das-labor/nixie-clock/README.md

# Nixie-Clock by das Labor
Our Nixie-Clock is a digital clock, which uses classical Nixie-tubes as hour, minute and second display. As tubes there are six kinds of the type Telefunken ZM 1210 used.

# Nixie-Uhr im Labor
Unsere Nixie-Uhr ist eine Digitaluhr, welche klassische Nixie-Röhren als Stunden, Minuten und Sekundenanzeige benutzt. Als Röhren werden sechs Röhren des Typs Telefunken ZM 1210 genutzt.

Weitere Informationen finden sich im [Wiki](http://das-labor.org/wiki/Nixie-Uhr).
