das-labor/nixie-clock/eagle/nixie-uhr-can.pdf

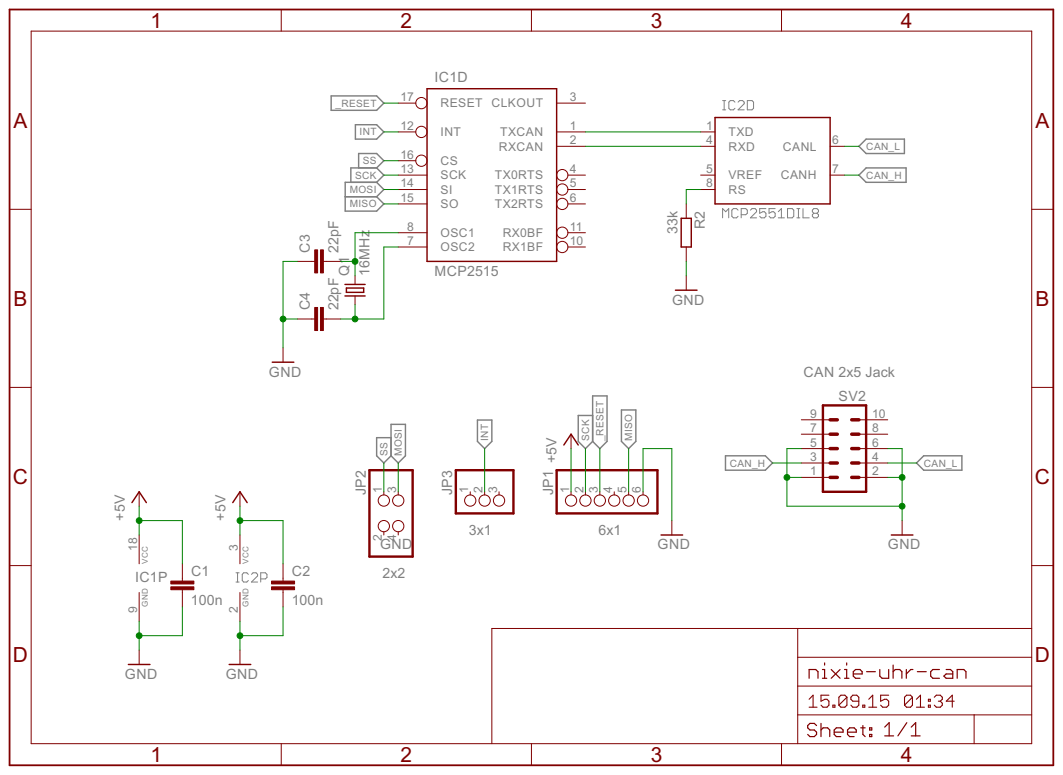
[picture p1: page 1]
