das-labor/nixie-clock/eagle/nixie-uhr.pdf

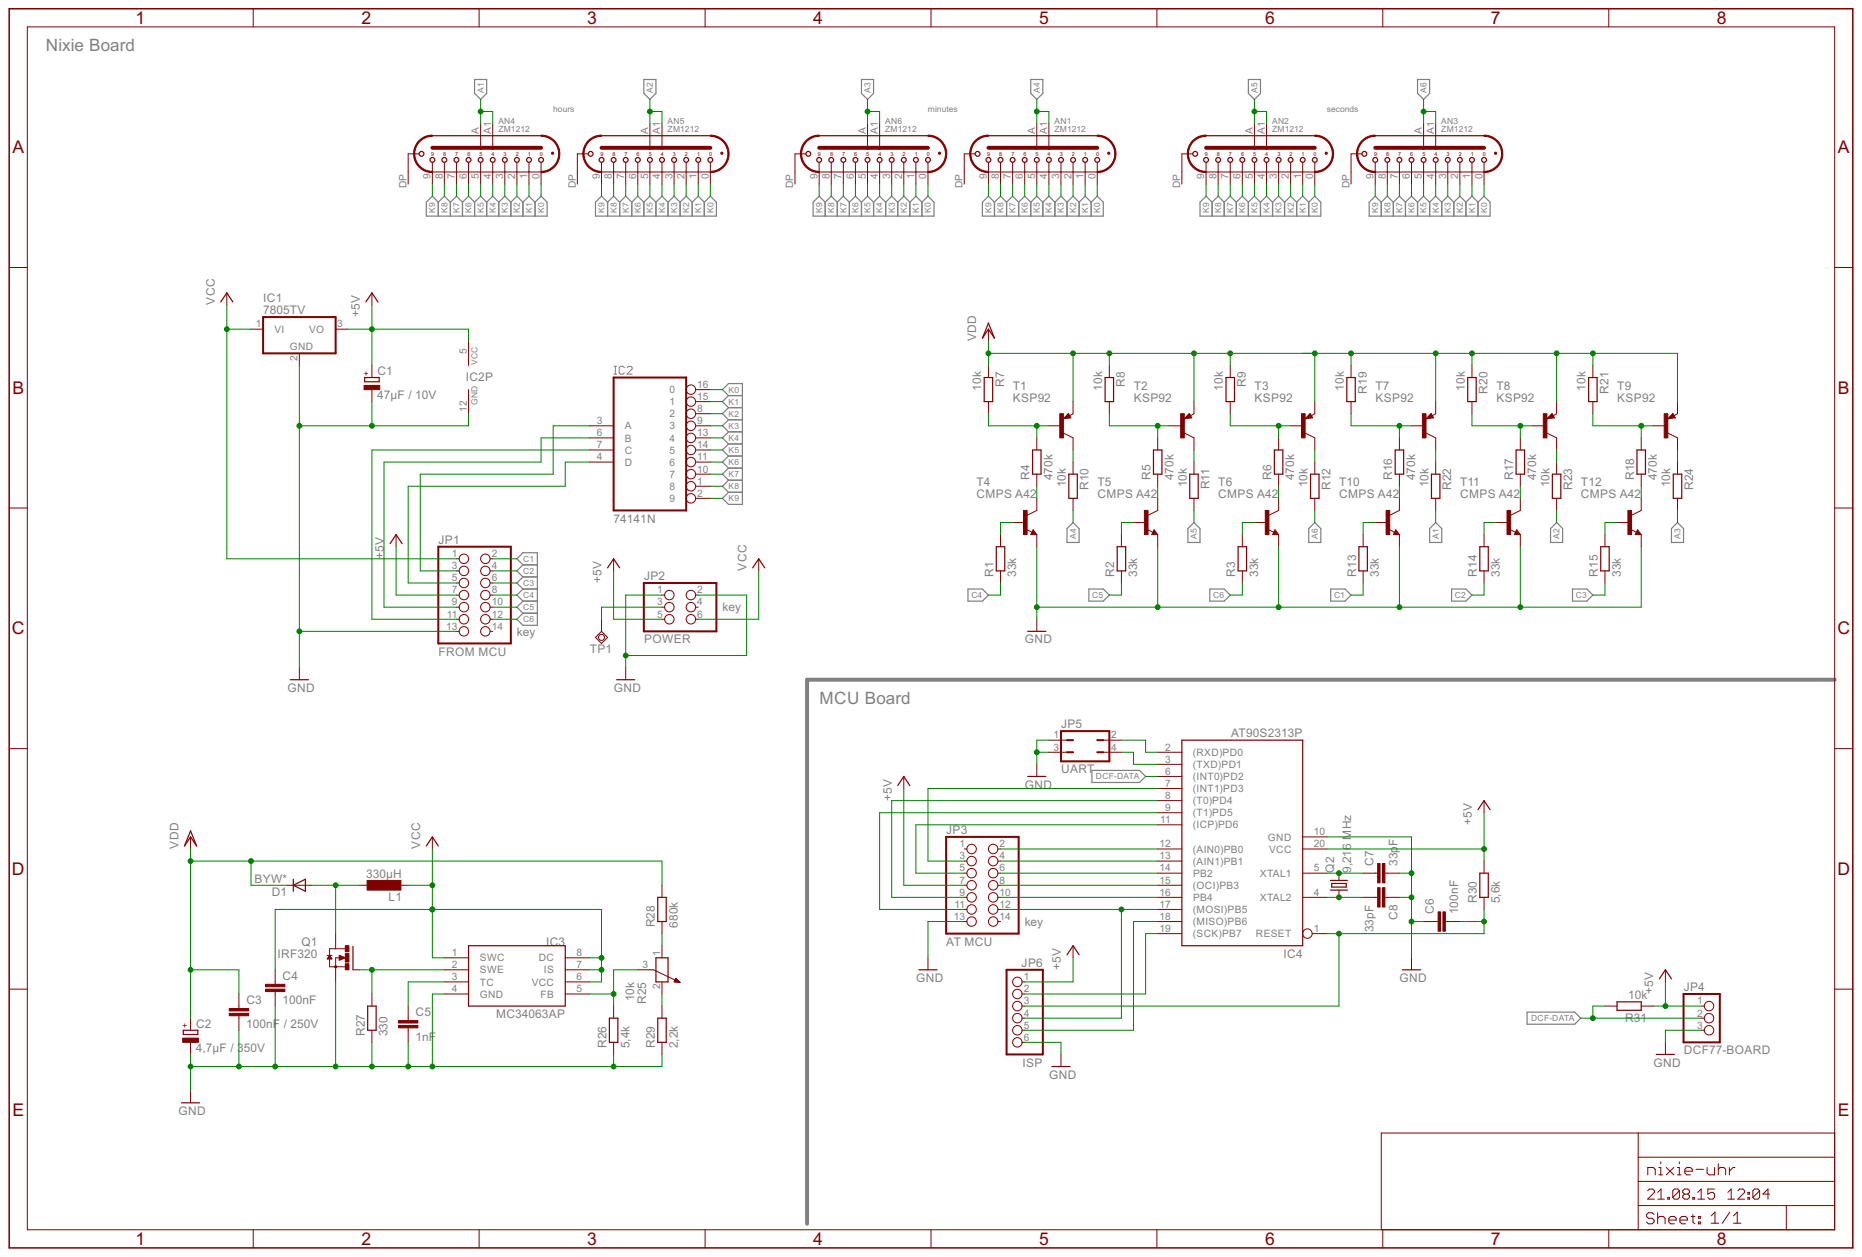
[picture p2: page 1]

11
