das-labor/nixie-clock/eagle/nixie-uhr-can.sch

## EAGLE design eagle/nixie-uhr-can.sch (2015-09-16)

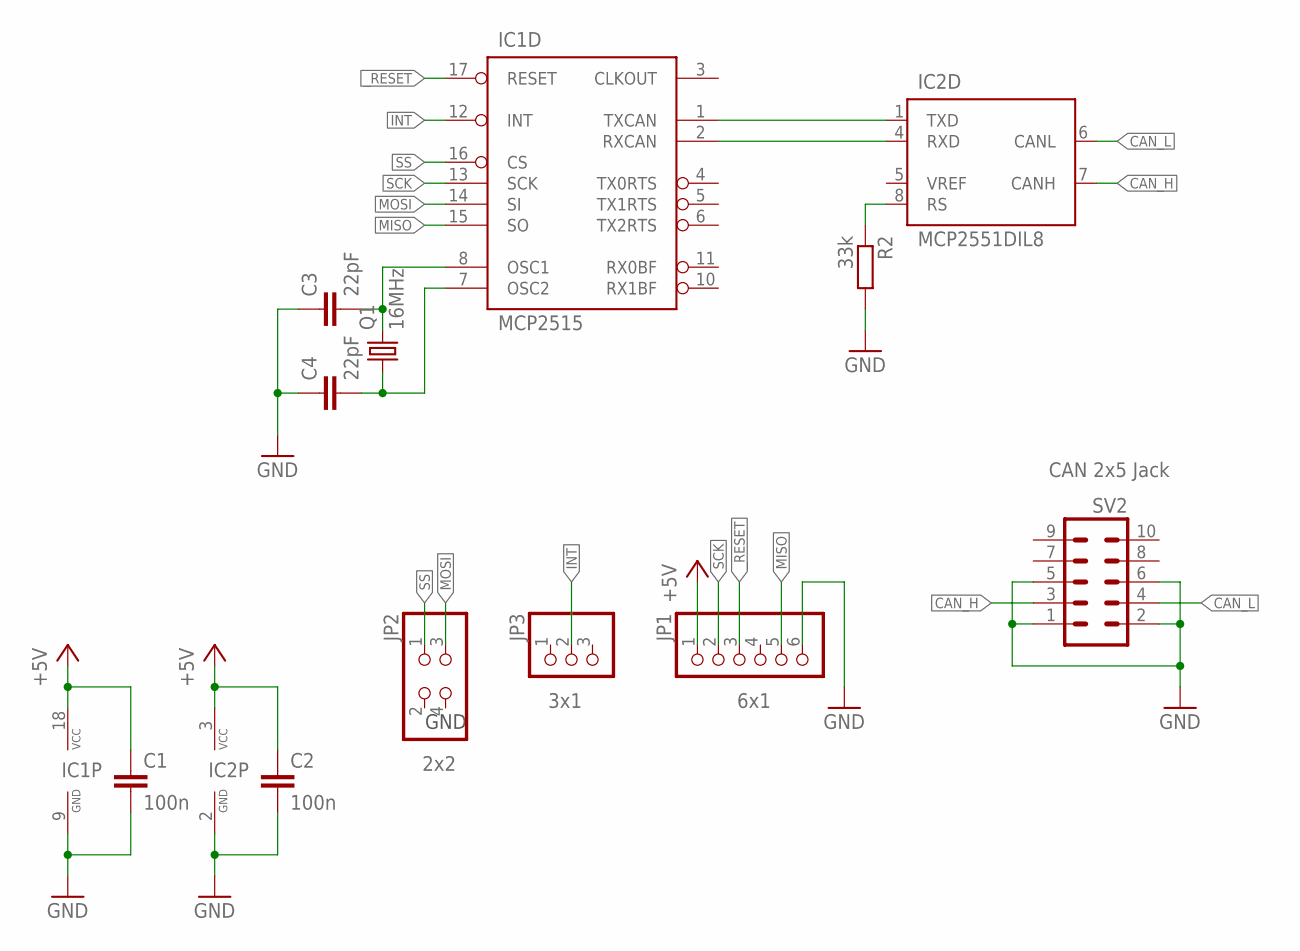
[picture p3: schematic nixie-uhr-can.sch]

Parts:
C1, C2: 100n; C050-024X044
C3, C4: 22pF; C0603
IC1: MCP2515; DIL18
IC2: MCP2551DIL8; DIL08
JP1: 6x1; 1X06/90
JP2: 2x2; 2X02
JP3: 3x1; 1X03
Q1: 16MHz; HC49UP
R2: 33k; 0204/7
SV2: CAN 2x5 Jack; ML10

Connections:
+5V: C1.1, C2.1, IC1.18 (VCC), IC2.3 (VCC), JP1.1
CAN_H: IC2.7 (CANH), SV2.3
CAN_L: IC2.6 (CANL), SV2.4
GND: C1.2, C2.2, C3.1, C4.1, IC1.9 (GND), IC2.2 (GND), JP1.6, R2.2, SV2.1, SV2.2, SV2.5, SV2.6
INT: IC1.12 (INT), JP3.2
MISO: IC1.15 (SO), JP1.5
MOSI: IC1.14 (SI), JP2.3
unnamed: C3.2, IC1.8 (OSC1), Q1.2
unnamed: C4.2, IC1.7 (OSC2), Q1.1
unnamed: IC2.8 (RS), R2.1
unnamed: IC1.1 (TXCAN), IC2.1 (TXD)
unnamed: IC1.2 (RXCAN), IC2.4 (RXD)
SCK: IC1.13 (SCK), JP1.2
SS: IC1.16 (CS), JP2.1
_RESET: IC1.17 (RESET), JP1.3

Notes on the sheet:
GND
