das-labor/nixie-clock/eagle/nixie-uhr.sch

## EAGLE design eagle/nixie-uhr.sch (2015-09-16)

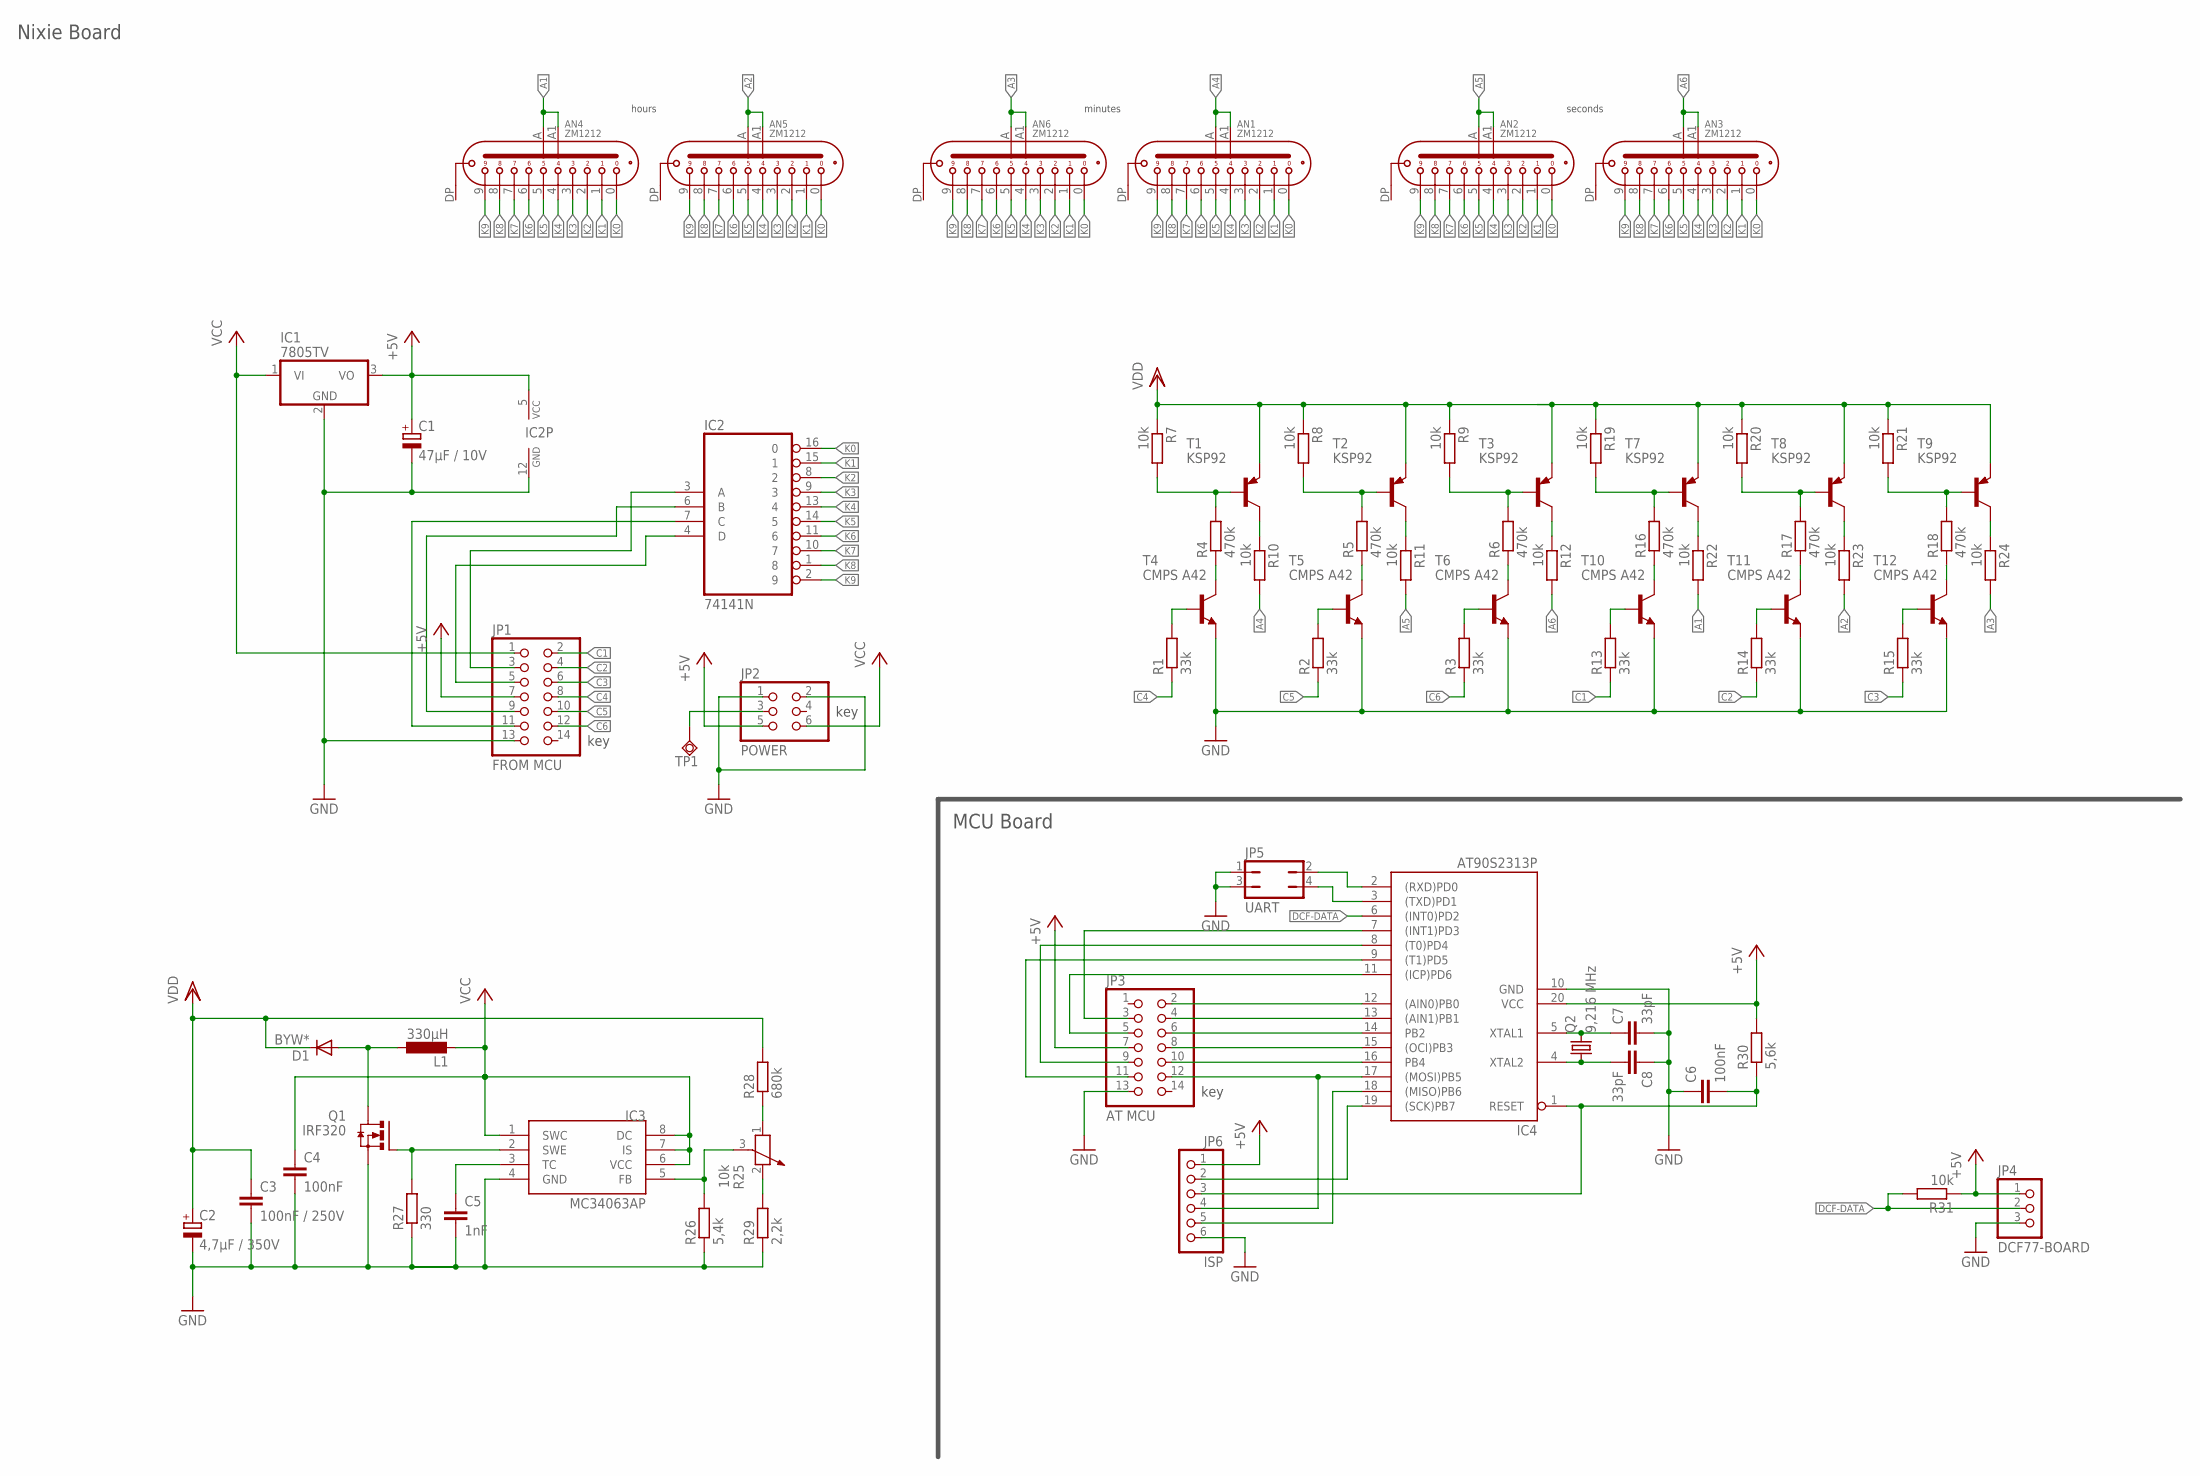
[picture p4: schematic nixie-uhr.sch]

Parts:
AN1, AN2, AN3, AN4, AN5, AN6: ZM1212; ZM1000
C1: 47µF / 10V; E2,5-5
C2: 4,7µF / 350V; E30-10
C3: 100nF / 250V; C075-052X106
C4, C6: 100nF; C050-024X044
C5: 1nF; C050-024X044
C7, C8: 33pF; C050-024X044
D1: BYW*; DO204-10
IC1: 7805TV; TO220V
IC2: 74141N; DIL16
IC3: MC34063AP; DIL08
IC4: AT90S2313P; DIL20
JP1: FROM MCU; 2X07
JP2: POWER; 2X03
JP3: AT MCU; 2X07
JP4: DCF77-BOARD; 1X03
JP5: UART; JP2Q
JP6: ISP; 1X06/90
L1: 330µH; 0207/7
Q1: IRF320; D2PACK
Q2: 9,216 MHz; HC49U-H
R1, R2, R3, R13, R14, R15: 33k; 0204/5
R4, R5, R6, R16, R17, R18: 470k; 0204/5
R7, R8, R9, R10, R11, R12, R19, R20, R21, R22, R23, R24, R31: 10k; 0204/5
R25: 10k; PT-SPIN
R26: 5,4k; 0207/7
R27: 330; 0207/7
R28: 680k; 0309/12
R29: 2,2k; 0309/12
R30: 5,6k; 0204/5
T1, T2, T3, T7, T8, T9: KSP92; TO92
T4, T5, T6, T10, T11, T12: CMPS A42; TO92-CBE
TP1: TPSQPAD1-17; P1-17

Connections:
+5V: C1.+, IC1.3 (VO), IC2.5 (VCC), IC4.20 (VCC), JP1.7, JP2.5, JP3.7, JP4.1, JP6.1, R30.2, R31.1
A1: AN4.A (A1), AN4.A1 (A2), R22.2
A2: AN5.A (A1), AN5.A1 (A2), R23.2
A3: AN6.A (A1), AN6.A1 (A2), R24.2
A4: AN1.A (A1), AN1.A1 (A2), R10.2
A5: AN2.A (A1), AN2.A1 (A2), R11.2
A6: AN3.A (A1), AN3.A1 (A2), R12.2
C1: JP1.2, R13.1
C2: JP1.4, R14.1
C3: JP1.6, R15.1
C4: JP1.8, R1.1
C5: JP1.10, R2.1
C6: JP1.12, R3.1
DCF-DATA: IC4.6 ((INT0)PD2), JP4.2, R31.2
GND: C1.-, C2.-, C3.2, C4.2, C5.2, C6.1, C7.2, C8.1, IC1.2 (GND), IC2.12 (GND), IC3.4 (GND), IC4.10 (GND), JP1.13, JP2.1, JP2.2, JP3.13, JP4.3, JP5.1, JP5.3, JP6.6, Q1.3 (S), R26.1, R27.1, R29.1, T4.E, T5.E, T6.E, T10.E, T11.E, T12.E
K0: AN1.0, AN2.0, AN3.0, AN4.0, AN5.0, AN6.0, IC2.16 (0)
K1: AN1.1, AN2.1, AN3.1, AN4.1, AN5.1, AN6.1, IC2.15 (1)
K2: AN1.2, AN2.2, AN3.2, AN4.2, AN5.2, AN6.2, IC2.8 (2)
K3: AN1.3, AN2.3, AN3.3, AN4.3, AN5.3, AN6.3, IC2.9 (3)
K4: AN1.4, AN2.4, AN3.4, AN4.4, AN5.4, AN6.4, IC2.13 (4)
K5: AN1.5, AN2.5, AN3.5, AN4.5, AN5.5, AN6.5, IC2.14 (5)
K6: AN1.6, AN2.6, AN3.6, AN4.6, AN5.6, AN6.6, IC2.11 (6)
K7: AN1.7, AN2.7, AN3.7, AN4.7, AN5.7, AN6.7, IC2.10 (7)
K8: AN1.8, AN2.8, AN3.8, AN4.8, AN5.8, AN6.8, IC2.1 (8)
K9: AN1.9, AN2.9, AN3.9, AN4.9, AN5.9, AN6.9, IC2.2 (9)
unnamed: R4.1, T4.C
unnamed: R5.1, T5.C
unnamed: R6.1, T6.C
unnamed: R4.2, R7.2, T1.2 (B)
unnamed: JP2.3, TP1.TP
unnamed: R5.2, R8.2, T2.2 (B)
unnamed: IC3.2 (SWE), Q1.1 (G), R27.2
unnamed: R1.2, T4.B
unnamed: R6.2, R9.2, T3.2 (B)
unnamed: R3.2, T6.B
unnamed: R2.2, T5.B
unnamed: D1.A, L1.1, Q1.2 (D)
unnamed: IC3.5 (FB), R25.3, R26.2
unnamed: R25.1, R28.1
unnamed: R11.1, T2.3 (C)
unnamed: R12.1, T3.3 (C)
unnamed: C5.1, IC3.3 (TC)
unnamed: R25.2, R29.2
unnamed: IC4.12 ((AIN0)PB0), JP3.2
unnamed: R10.1, T1.3 (C)
unnamed: IC2.3 (A), JP1.3
unnamed: IC2.4 (D), JP1.5
unnamed: IC2.6 (B), JP1.9
unnamed: IC2.7 (C), JP1.11
unnamed: R13.2, T10.B
unnamed: R15.2, T12.B
unnamed: R14.2, T11.B
unnamed: R16.1, T10.C
unnamed: R17.1, T11.C
unnamed: R18.1, T12.C
unnamed: R16.2, R19.2, T7.2 (B)
unnamed: R17.2, R20.2, T8.2 (B)
unnamed: R18.2, R21.2, T9.2 (B)
unnamed: IC4.7 ((INT1)PD3), JP3.3
unnamed: R23.1, T8.3 (C)
unnamed: R24.1, T9.3 (C)
unnamed: R22.1, T7.3 (C)
unnamed: IC4.13 ((AIN1)PB1), JP3.4
unnamed: IC4.17 ((MOSI)PB5), JP3.12, JP6.4
unnamed: IC4.16 (PB4), JP3.10
unnamed: IC4.15 ((OCI)PB3), JP3.8
unnamed: IC4.14 (PB2), JP3.6
unnamed: IC4.11 ((ICP)PD6), JP3.5
unnamed: IC4.3 ((TXD)PD1), JP5.4
unnamed: IC4.8 ((T0)PD4), JP3.9
unnamed: IC4.9 ((T1)PD5), JP3.11
unnamed: C7.1, IC4.5 (XTAL1), Q2.2
unnamed: C8.2, IC4.4 (XTAL2), Q2.1
unnamed: C6.2, IC4.1 (RESET), JP6.3, R30.1
unnamed: IC4.2 ((RXD)PD0), JP5.2
unnamed: IC4.18 ((MISO)PB6), JP6.5
unnamed: IC4.19 ((SCK)PB7), JP6.2
VCC: C4.1, IC1.1 (VI), IC3.1 (SWC), IC3.6 (VCC), IC3.7 (IS), IC3.8 (DC), JP1.1, JP2.6, L1.2
VDD: C2.+, C3.1, D1.C, R7.1, R8.1, R9.1, R19.1, R20.1, R21.1, R28.2, T1.1 (E), T2.1 (E), T3.1 (E), T7.1 (E), T8.1 (E), T9.1 (E)

Notes on the sheet:
key
seconds
minutes
hours
MCU Board
Nixie Board
