das-labor/nixie-clock/(commit log)

2015-09-11 MISO Pin Bug fixed...
    [config.h]
2015-09-16 Pin bug fixed
2015-09-16 eagle schematics added
    [nixie-uhr-can.sch, nixie-uhr.sch]
2015-09-16 PDF files of schematic added
